cruzsbrian/smartwatch/watch_hw/watch.kicad_pcb

## KiCad design watch_hw/watch.kicad_pcb (2026-02-01)

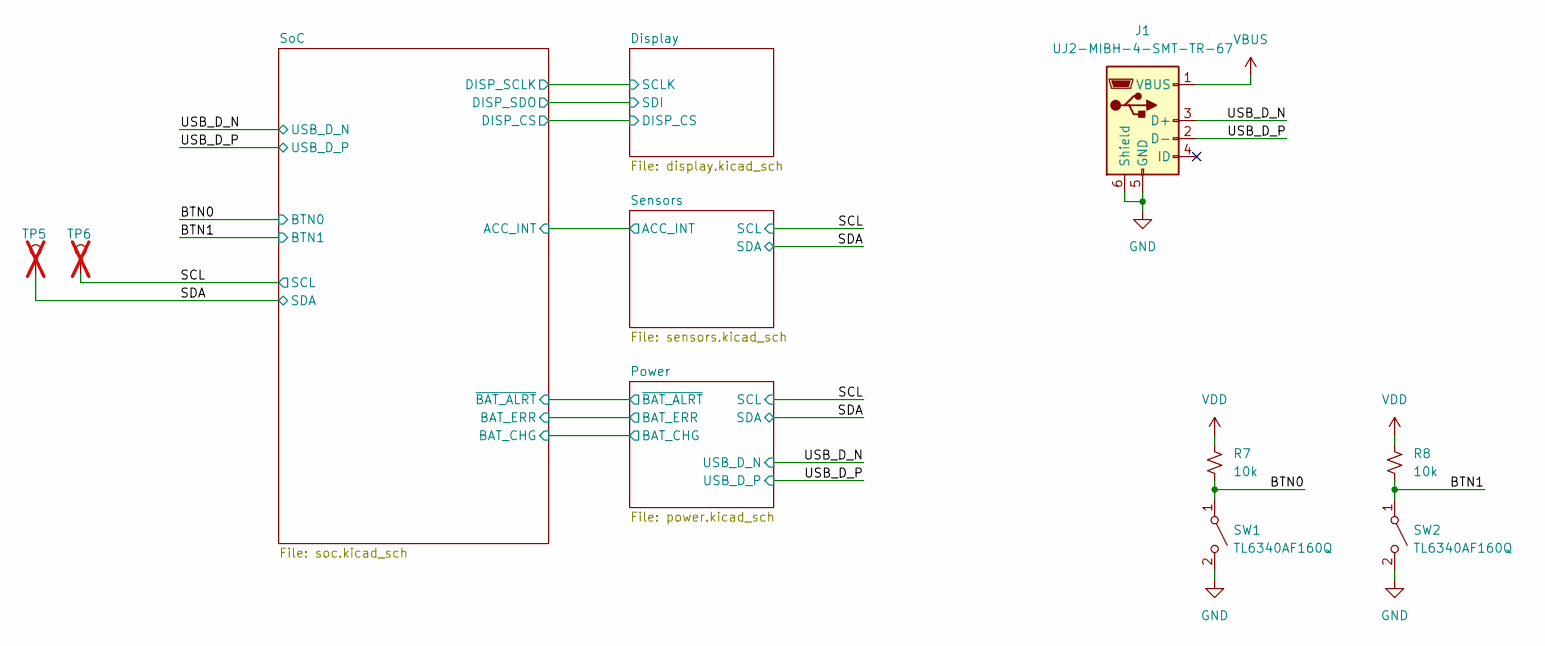
[picture p1: schematic watch.kicad_sch]

Parts:
J1: UJ2-MIBH-4-SMT-TR-67; Manufacturer Part Number UJ2-MIBH-4-SMT-TR-67; LCSC C22359766
R7, R8: 10k; R_0402_1005Metric_Pad0.72x0.64mm_HandSolder; Manufacturer Part Number 0402WGF1002TCE; LCSC C25744
SW1, SW2: TL6340AF160Q; SW_TL6340AF160Q; Manufacturer Part Number TL6340AF160Q; LCSC C4944967
TP5, TP6: TestPoint; TestPoint_Keystone_5015_Micro_Mini; not fitted

Connections:
/BTN0: R7.2, SW1.1 (A); also elsewhere on the board
/BTN1: R8.2, SW2.1 (A); also elsewhere on the board
/SCL: TP6.1; also elsewhere on the board
/SDA: TP5.1; also elsewhere on the board
/USB_D_N: J1.3 (D+); also elsewhere on the board
/USB_D_P: J1.2 (D-); also elsewhere on the board
GND: J1.5 (GND), J1.6 (Shield), SW1.2 (B), SW2.2 (B); also elsewhere on the board
VBUS: J1.1 (VBUS); also elsewhere on the board
VDD: R7.1, R8.1; also elsewhere on the board

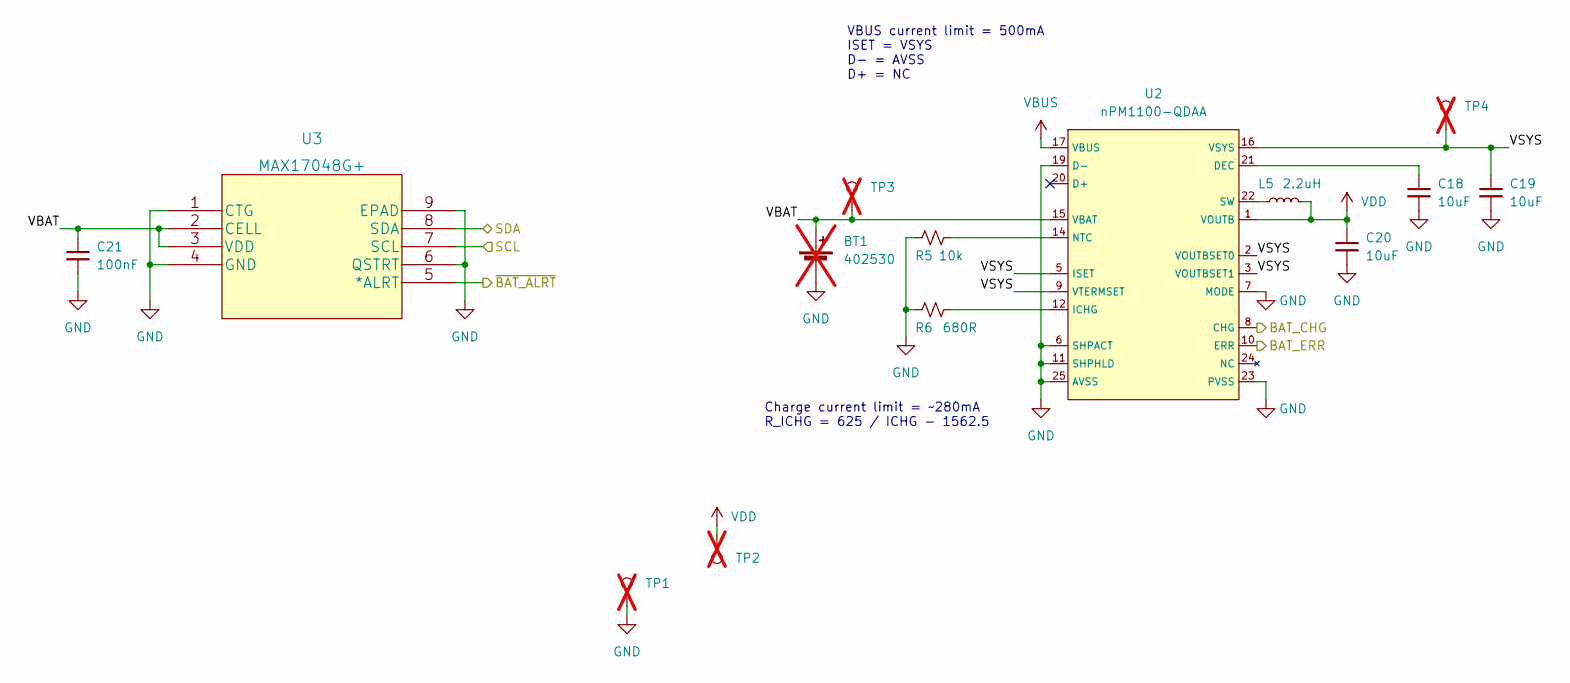
[picture p2: schematic power.kicad_sch]

Parts:
BT1: 402530; PinHeader_1x02_P1.27mm_Vertical; not fitted
C18, C19, C20: 10uF; C_0805_2012Metric_Pad1.18x1.45mm_HandSolder; Manufacturer Part Number CL21A106KAYNNNE; LCSC C15850
C21: 100nF; C_0402_1005Metric_Pad0.74x0.62mm_HandSolder; Manufacturer Part Number CL05B104KO5NNNC; LCSC C1525
L5: 2.2uH; L_0805_2012Metric_Pad1.05x1.20mm_HandSolder; Manufacturer Part Number LQM21PN2R2MGHL; LCSC C341781
R5: 10k; R_0402_1005Metric_Pad0.72x0.64mm_HandSolder; Manufacturer Part Number 0402WGF1002TCE; LCSC C25744
R6: 680R; R_0402_1005Metric_Pad0.72x0.64mm_HandSolder; Manufacturer Part Number 0402WGF6800TCE; LCSC C25130
TP1, TP2, TP3, TP4: TestPoint; TestPoint_Keystone_5015_Micro_Mini; not fitted
U2: nPM1100-QDAA; QFN-24-1EP_4x4mm_P0.5mm_EP2.15x2.15mm; Manufacturer Part Number NPM1100-QDAA-R; LCSC C5816773
U3: MAX17048G+; MAX17048G&plus_; Manufacturer Part Number MAX17048G+T10; LCSC C2682616

Connections:
/Power/BAT_CHG: U2.8 (CHG); also elsewhere on the board
/Power/BAT_ERR: U2.10 (ERR); also elsewhere on the board
/Power/VBAT: BT1.1 (+), C21.1, TP3.1, U2.15 (VBAT), U3.2 (CELL), U3.3 (VDD)
/Power/VSYS: C19.1, TP4.1, U2.2 (VOUTBSET0), U2.3 (VOUTBSET1), U2.5 (ISET), U2.9 (VTERMSET), U2.16 (VSYS)
/Power/~BAT_ALRT: U3.5 (*ALRT); also elsewhere on the board
/SCL: U3.7 (SCL); also elsewhere on the board
/SDA: U3.8 (SDA); also elsewhere on the board
GND: BT1.2 (-), C18.2, C19.2, C20.2, C21.2, R5.1, R6.1, TP1.1, U2.6 (SHPACT), U2.7 (MODE), U2.11 (SHPHLD), U2.19 (D-), U2.23 (PVSS), U2.25 (AVSS), U3.1 (CTG), U3.4 (GND), U3.6 (QSTRT), U3.9 (EPAD); also elsewhere on the board
unnamed: C18.1, U2.21 (DEC)
unnamed: R6.2, U2.12 (ICHG)
unnamed: R5.2, U2.14 (NTC)
unnamed: L5.1, U2.22 (SW)
VBUS: U2.17 (VBUS); also elsewhere on the board
VDD: C20.1, L5.2, TP2.1, U2.1 (VOUTB); also elsewhere on the board

Notes on the sheet:
Charge current limit = ~280mA R_ICHG = 625 / ICHG - 1562.5
VBUS current limit = 500mA ISET = VSYS D- = AVSS D+ = NC

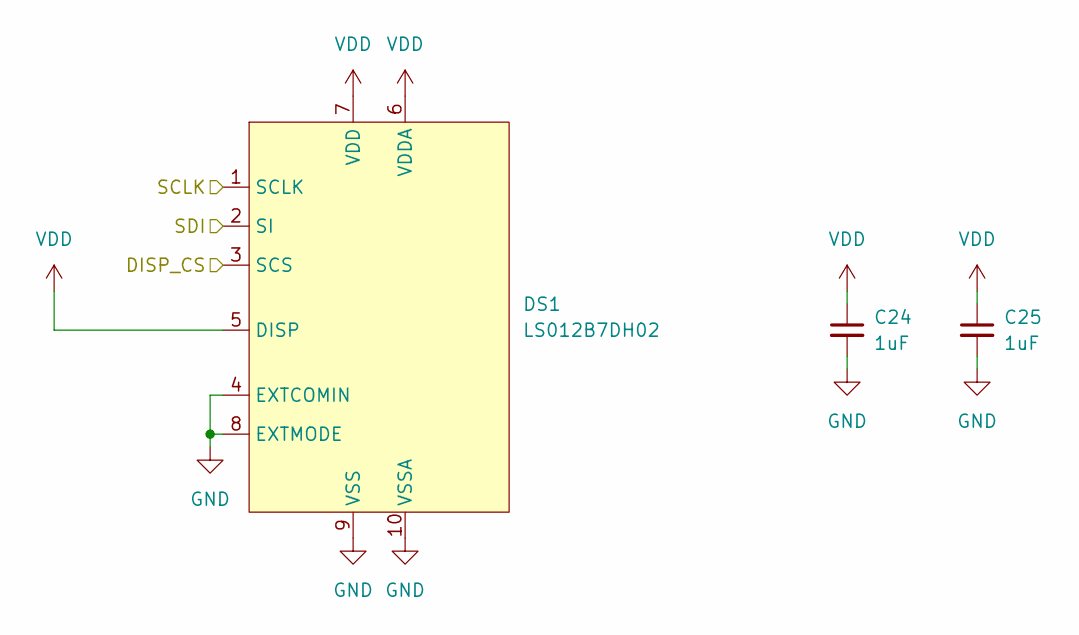
[picture p3: schematic display.kicad_sch]

Parts:
C24, C25: 1uF; C_0402_1005Metric_Pad0.74x0.62mm_HandSolder; Manufacturer Part Number CL05A105KA5NQNC; LCSC C52923
DS1: LS012B7DH02; AYF531035A; Manufacturer Part Number AYF531035A

Connections:
/Display/DISP_CS: DS1.3 (SCS); also elsewhere on the board
/Display/SCLK: DS1.1 (SCLK); also elsewhere on the board
/Display/SDI: DS1.2 (SI); also elsewhere on the board
GND: C24.2, C25.2, DS1.4 (EXTCOMIN), DS1.8 (EXTMODE), DS1.9 (VSS), DS1.10 (VSSA); also elsewhere on the board
VDD: C24.1, C25.1, DS1.5 (DISP), DS1.6 (VDDA), DS1.7 (VDD); also elsewhere on the board

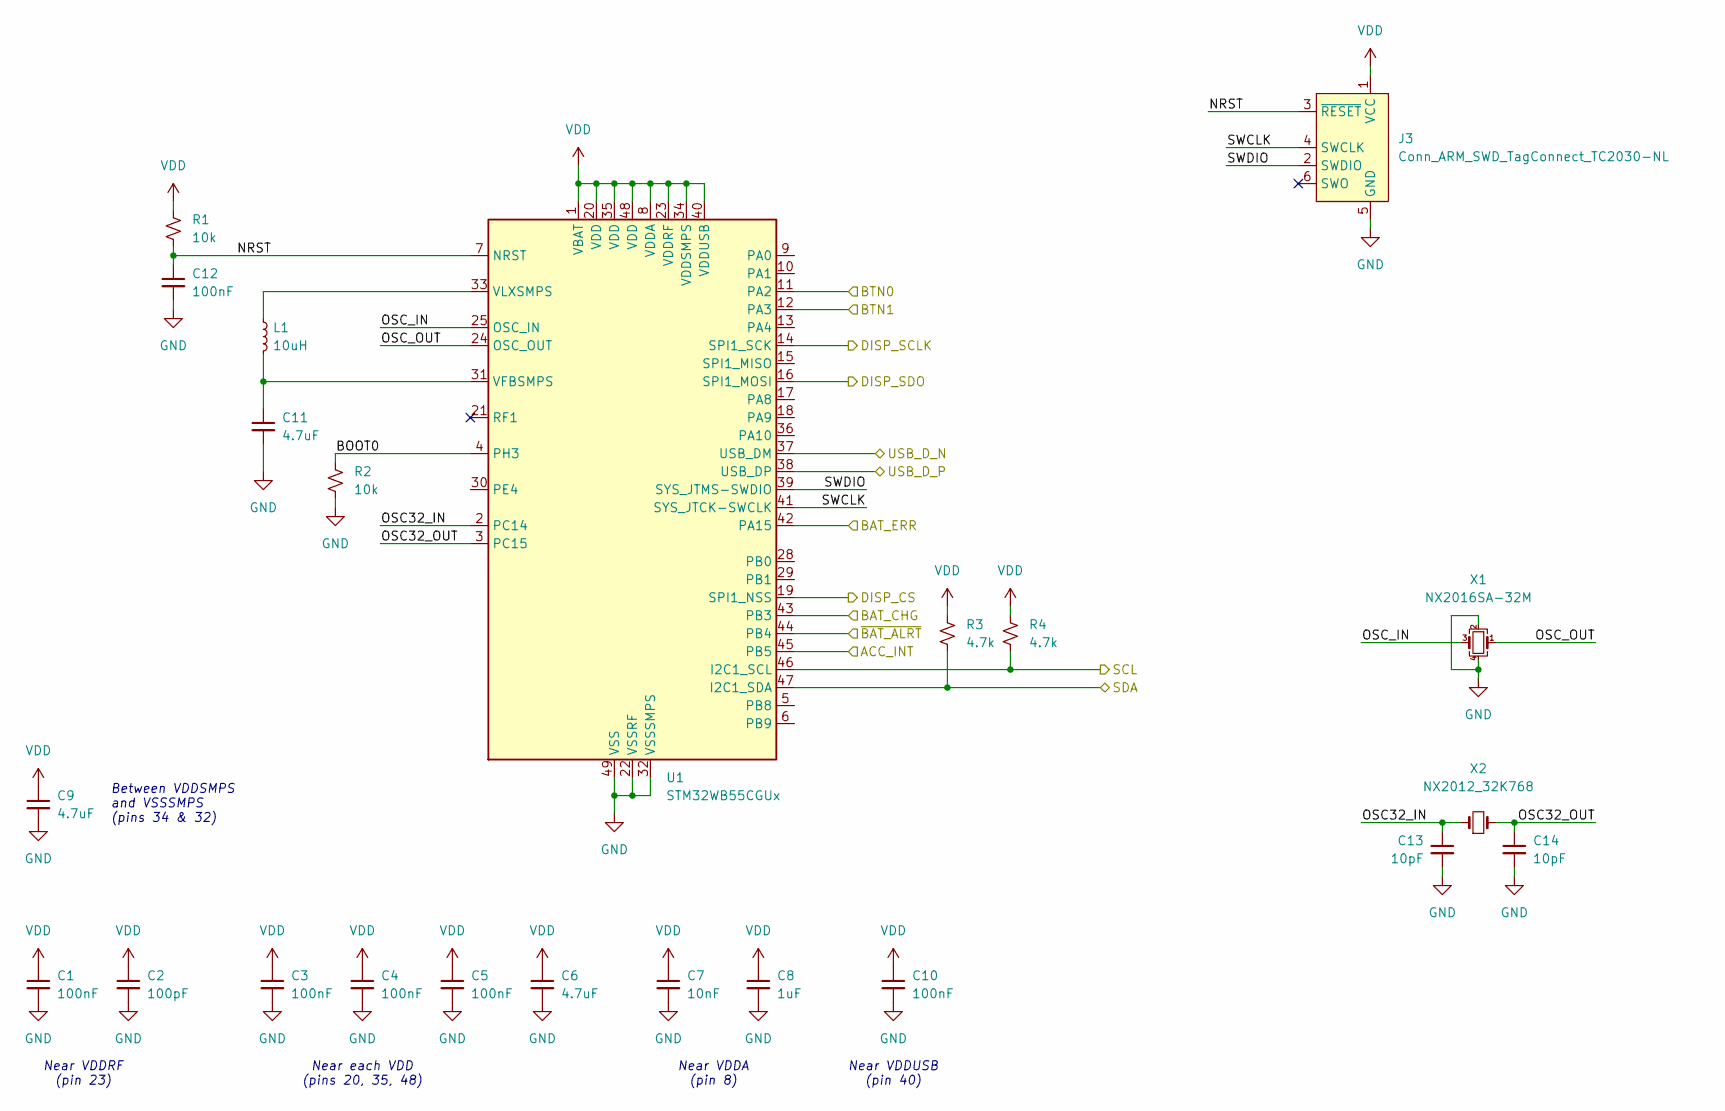
[picture p4: schematic soc.kicad_sch]

Parts:
C1, C3, C4, C5, C10, C12: 100nF; C_0402_1005Metric_Pad0.74x0.62mm_HandSolder; Manufacturer Part Number CL05B104KO5NNNC; LCSC C1525
C2: 100pF; C_0402_1005Metric_Pad0.74x0.62mm_HandSolder; Manufacturer Part Number CL05C101JB5NNNC; LCSC C26409
C6: 4.7uF; C_0402_1005Metric_Pad0.74x0.62mm_HandSolder; Manufacturer Part Number CL05A475MP5NRNC; LCSC C23733
C7: 10nF; C_0402_1005Metric_Pad0.74x0.62mm_HandSolder; Manufacturer Part Number CL05B103KB5NNNC; LCSC C15195
C8: 1uF; C_0402_1005Metric_Pad0.74x0.62mm_HandSolder; Manufacturer Part Number CL05A105KA5NQNC; LCSC C52923
C9, C11: 4.7uF; C_0603_1608Metric_Pad1.08x0.95mm_HandSolder; Manufacturer Part Number CL10A475KO8NNNC; LCSC C19666
C13, C14: 10pF; C_0402_1005Metric_Pad0.74x0.62mm_HandSolder; Manufacturer Part Number CL05C100JB5NNNC; LCSC C32949
J3: Conn_ARM_SWD_TagConnect_TC2030-NL; Tag-Connect_TC2030-IDC-NL_2x03_P1.27mm_Vertical
L1: 10uH; L_0805_2012Metric_Pad1.05x1.20mm_HandSolder; Manufacturer Part Number LQM21FN100M80L; LCSC C162582
R1, R2: 10k; R_0402_1005Metric_Pad0.72x0.64mm_HandSolder; Manufacturer Part Number 0402WGF1002TCE; LCSC C25744
R3, R4: 4.7k; R_0402_1005Metric_Pad0.72x0.64mm_HandSolder; Manufacturer Part Number 0402WGF4701TCE; LCSC C25900
U1: STM32WB55CGUx; QFN-48-1EP_7x7mm_P0.5mm_EP3.5x3.5mm; Manufacturer Part Number STM32WB55CGU6; LCSC C404023
X1: NX2016SA-32M; Crystal_SMD_2016-4Pin_2.0x1.6mm; Manufacturer Part Number NX2016SA-32MHZ-STD-CZS-5; LCSC C843260
X2: NX2012_32K768; Crystal_SMD_2012-2Pin_2.0x1.2mm_HandSoldering; Manufacturer Part Number NX2012SA-32.768KHZ-STD-MUB-2; LCSC C891748

Connections:
/BTN0: U1.11 (PA2); also elsewhere on the board
/BTN1: U1.12 (PA3); also elsewhere on the board
/Display/DISP_CS: U1.19 (SPI1_NSS); also elsewhere on the board
/Display/SCLK: U1.14 (SPI1_SCK); also elsewhere on the board
/Display/SDI: U1.16 (SPI1_MOSI); also elsewhere on the board
/Power/BAT_CHG: U1.43 (PB3); also elsewhere on the board
/Power/BAT_ERR: U1.42 (PA15); also elsewhere on the board
/Power/~BAT_ALRT: U1.44 (PB4); also elsewhere on the board
/SCL: R4.2, U1.46 (I2C1_SCL); also elsewhere on the board
/SDA: R3.2, U1.47 (I2C1_SDA); also elsewhere on the board
/Sensors/ACC_INT: U1.45 (PB5); also elsewhere on the board
/SoC/BOOT0: R2.1, U1.4 (PH3)
/SoC/NRST: C12.1, J3.3 (~RESET), R1.2, U1.7 (NRST)
/SoC/OSC32_IN: C13.1, U1.2 (PC14), X2.1
/SoC/OSC32_OUT: C14.1, U1.3 (PC15), X2.2
/SoC/OSC_IN: U1.25 (OSC_IN), X1.3
/SoC/OSC_OUT: U1.24 (OSC_OUT), X1.1
/SoC/SWCLK: J3.4 (SWCLK), U1.41 (SYS_JTCK-SWCLK)
/SoC/SWDIO: J3.2 (SWDIO), U1.39 (SYS_JTMS-SWDIO)
/USB_D_N: U1.37 (USB_DM); also elsewhere on the board
/USB_D_P: U1.38 (USB_DP); also elsewhere on the board
GND: C1.2, C2.2, C3.2, C4.2, C5.2, C6.2, C7.2, C8.2, C9.2, C10.2, C11.2, C12.2, C13.2, C14.2, J3.5 (GND), R2.2, U1.22 (VSSRF), U1.32 (VSSSMPS), U1.49 (VSS), X1.2, X1.4; also elsewhere on the board
unnamed: C11.1, L1.2, U1.31 (VFBSMPS)
unnamed: L1.1, U1.33 (VLXSMPS)
VDD: C1.1, C2.1, C3.1, C4.1, C5.1, C6.1, C7.1, C8.1, C9.1, C10.1, J3.1 (VCC), R1.1, R3.1, R4.1, U1.1 (VBAT), U1.8 (VDDA), U1.20 (VDD), U1.23 (VDDRF), U1.34 (VDDSMPS), U1.35 (VDD), U1.40 (VDDUSB), U1.48 (VDD); also elsewhere on the board

Notes on the sheet:
Near VDDUSB (pin 40)
Between VDDSMPS and VSSSMPS (pins 34 & 32)
Near VDDA (pin 8)
Near each VDD (pins 20, 35, 48)
Near VDDRF (pin 23)

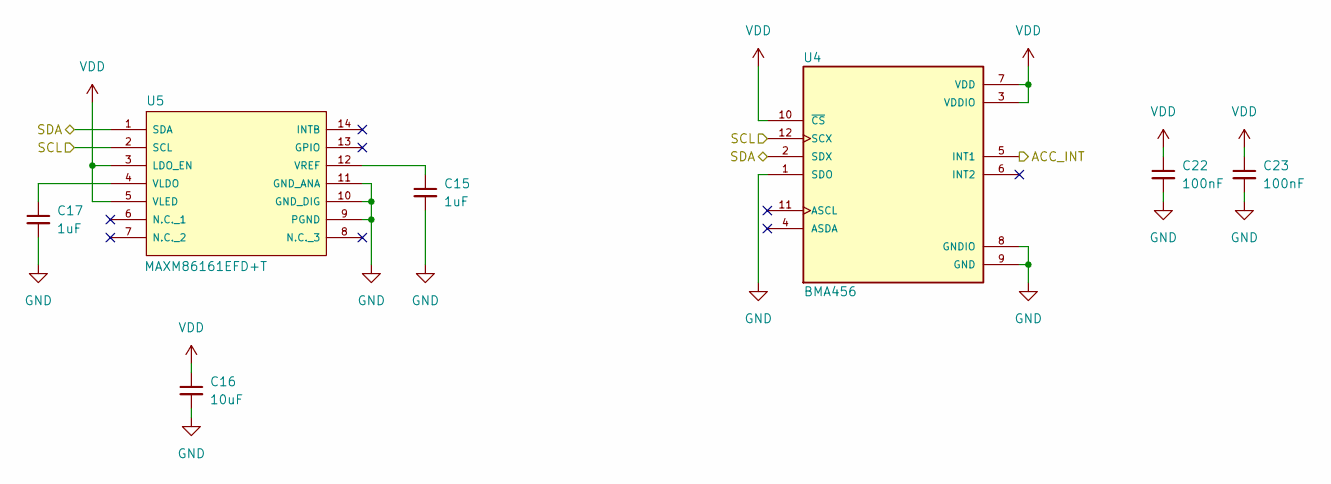
[picture p5: schematic sensors.kicad_sch]

Parts:
C15, C17: 1uF; C_0402_1005Metric_Pad0.74x0.62mm_HandSolder; Manufacturer Part Number CL05A105KA5NQNC; LCSC C52923
C16: 10uF; C_0805_2012Metric_Pad1.18x1.45mm_HandSolder; Manufacturer Part Number CL21A106KAYNNNE; LCSC C15850
C22, C23: 100nF; C_0402_1005Metric_Pad0.74x0.62mm_HandSolder; Manufacturer Part Number CL05B104KO5NNNC; LCSC C1525
U4: BMA456; XDCR_BMA456; PARTREV 2.0; LCSC C189518
U5: MAXM86161EFD+T; MAXM86161EFDT; Manufacturer Part Number MAXM86161EFD+T; LCSC C3178309

Connections:
/SCL: U4.12 (SCX), U5.2 (SCL); also elsewhere on the board
/SDA: U4.2 (SDX), U5.1 (SDA); also elsewhere on the board
/Sensors/ACC_INT: U4.5 (INT1); also elsewhere on the board
GND: C15.2, C16.2, C17.2, C22.2, C23.2, U4.1 (SDO), U4.8 (GNDIO), U4.9 (GND), U5.9 (PGND), U5.10 (GND_DIG), U5.11 (GND_ANA); also elsewhere on the board
unnamed: C17.1, U5.4 (VLDO)
unnamed: C15.1, U5.12 (VREF)
VDD: C16.1, C22.1, C23.1, U4.3 (VDDIO), U4.7 (VDD), U4.10 (~CS), U5.3 (LDO_EN), U5.5 (VLED); also elsewhere on the board

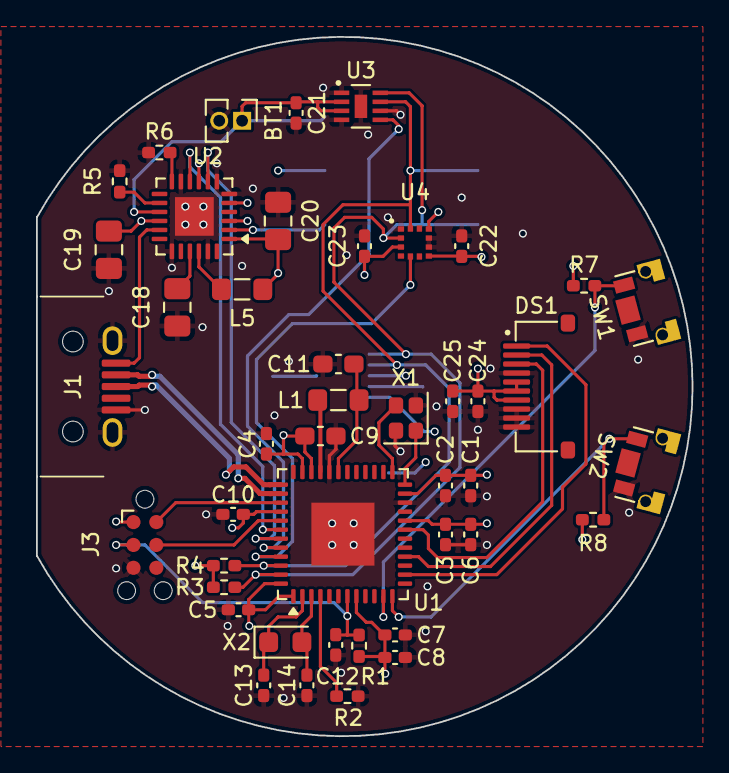
[picture p6: board watch.kicad_pcb from above]

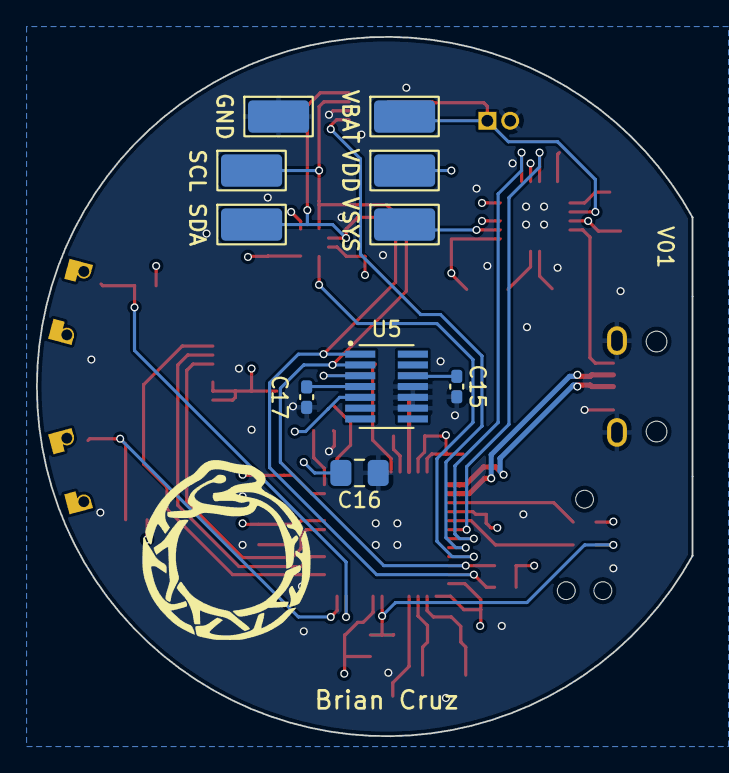
[picture p7: board watch.kicad_pcb from below]

Board: 6 copper layers, 36.4 x 38.8 mm, 55 parts (10 on the bottom side), 34 nets.

Other parts of the board:
DISP: LS012B7DH02
