cruzsbrian/smartwatch/breakout_boards/hr_brkt/hr_brkt.kicad_pcb

## KiCad design breakout_boards/hr_brkt/hr_brkt.kicad_pcb (2024-07-24)

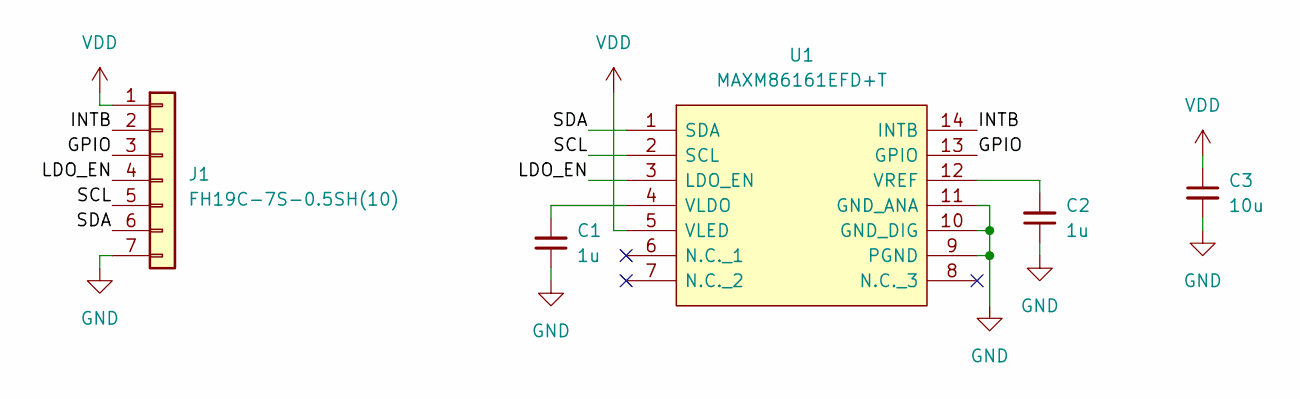
[picture p8: schematic hr_brkt.kicad_sch]

Parts:
C1, C2: 1u; C_0402_1005Metric_Pad0.74x0.62mm_HandSolder
C3: 10u; C_0402_1005Metric_Pad0.74x0.62mm_HandSolder
J1: FH19C-7S-0.5SH(10); FH19C_FPC
U1: MAXM86161EFD+T; MAXM86161EFDT; Mouser Part Number 700-MAXM86161EFD+T

Connections:
/GPIO: J1.3, U1.13 (GPIO)
/INTB: J1.2, U1.14 (INTB)
/LDO_EN: J1.4, U1.3 (LDO_EN)
/SCL: J1.5, U1.2 (SCL)
/SDA: J1.6, U1.1 (SDA)
GND: C1.1, C2.1, C3.2, J1.7, U1.9 (PGND), U1.10 (GND_DIG), U1.11 (GND_ANA)
unnamed: C1.2, U1.4 (VLDO)
unnamed: C2.2, U1.12 (VREF)
VDD: C3.1, J1.1, U1.5 (VLED)

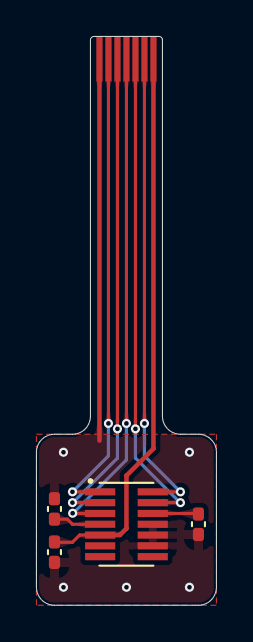
[picture p9: board hr_brkt.kicad_pcb from above]

Board: 2 copper layers, 10.0 x 31.6 mm, 5 parts (0 on the bottom side), 9 nets.
