cruzsbrian/smartwatch/breakout_boards/acc_brkt/acc_brkt.kicad_pcb

## KiCad design breakout_boards/acc_brkt/acc_brkt.kicad_pcb (2024-07-24)

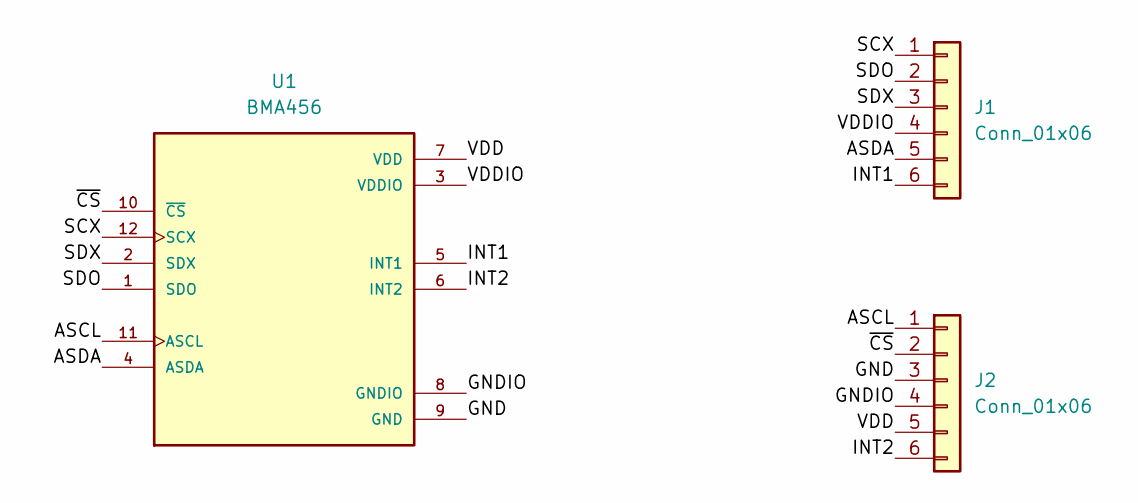
[picture p10: schematic acc_brkt.kicad_sch]

Parts:
J1, J2: Conn_01x06; PinHeader_1x06_P2.54mm_Vertical
U1: BMA456; XDCR_BMA456; PARTREV 2.0

Connections:
/ASCL: J2.1, U1.11 (ASCL)
/ASDA: J1.5, U1.4 (ASDA)
/GND: J2.3, U1.9 (GND)
/GNDIO: J2.4, U1.8 (GNDIO)
/INT1: J1.6, U1.5 (INT1)
/INT2: J2.6, U1.6 (INT2)
/SCX: J1.1, U1.12 (SCX)
/SDO: J1.2, U1.1 (SDO)
/SDX: J1.3, U1.2 (SDX)
/VDD: J2.5, U1.7 (VDD)
/VDDIO: J1.4, U1.3 (VDDIO)
/~CS: J2.2, U1.10 (~CS)

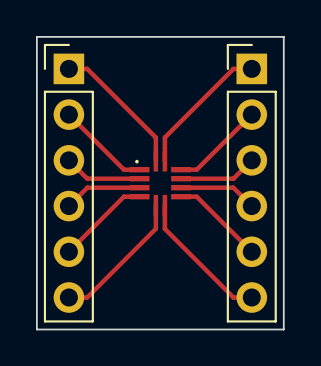
[picture p11: board acc_brkt.kicad_pcb from above]

Board: 2 copper layers, 13.7 x 16.3 mm, 3 parts (0 on the bottom side), 12 nets.
