cruzsbrian/smartwatch/breakout_boards/reflective_lcd_brkt/reflective_lcd_brkt.kicad_pcb

## KiCad design breakout_boards/reflective_lcd_brkt/reflective_lcd_brkt.kicad_pcb (2024-07-24)

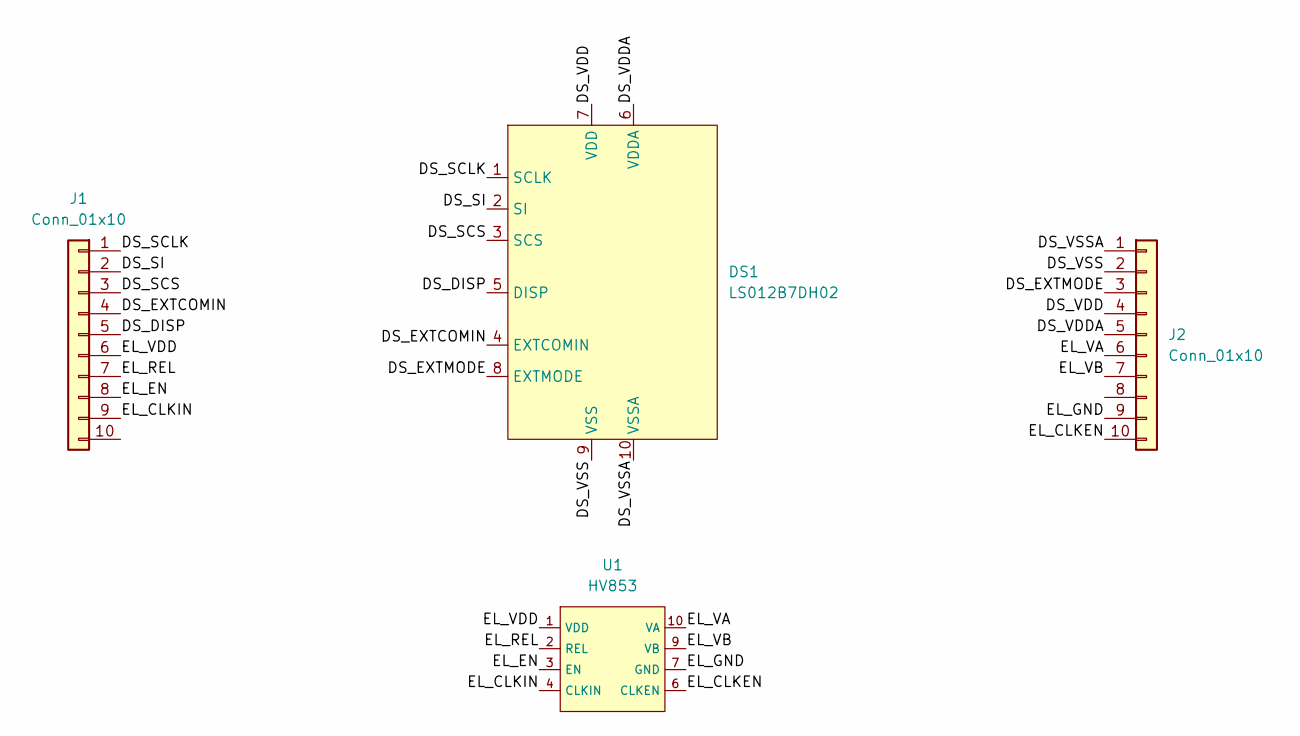
[picture p12: schematic reflective_lcd_brkt.kicad_sch]

Parts:
DS1: LS012B7DH02; AYF531035A
J1: Conn_01x10
J2: Conn_01x10; PinHeader_1x10_P2.54mm_Vertical
U1: HV853; DFN-10-1EP_3x3mm_P0.5mm_EP1.65x2.38mm

Connections:
/DS_DISP: DS1.5 (DISP), J1.5
/DS_EXTCOMIN: DS1.4 (EXTCOMIN), J1.4
/DS_EXTMODE: DS1.8 (EXTMODE), J2.3
/DS_SCLK: DS1.1 (SCLK), J1.1
/DS_SCS: DS1.3 (SCS), J1.3
/DS_SI: DS1.2 (SI), J1.2
/DS_VDD: DS1.7 (VDD), J2.4
/DS_VDDA: DS1.6 (VDDA), J2.5
/DS_VSS: DS1.9 (VSS), J2.2
/DS_VSSA: DS1.10 (VSSA), J2.1
/EL_CLKEN: J2.10, U1.6 (CLKEN)
/EL_CLKIN: J1.9, U1.4 (CLKIN)
/EL_EN: J1.8, U1.3 (EN)
/EL_REL: J1.7, U1.2 (REL)
/EL_VA: J2.6, U1.10 (VA)
/EL_VB: J2.7, U1.9 (VB)
/EL_VDD: J1.6, U1.1 (VDD)
GND: J2.8, J2.9, U1.7 (GND), U1.8 (GND)

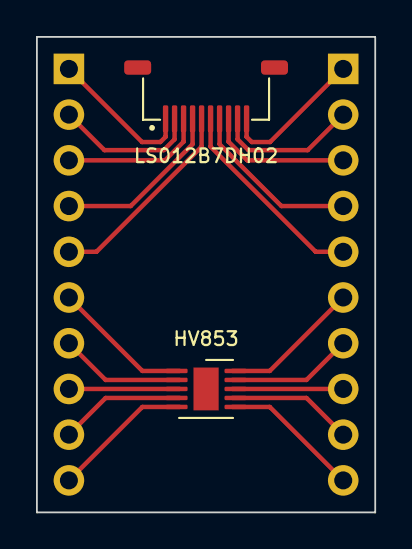
[picture p13: board reflective_lcd_brkt.kicad_pcb from above]

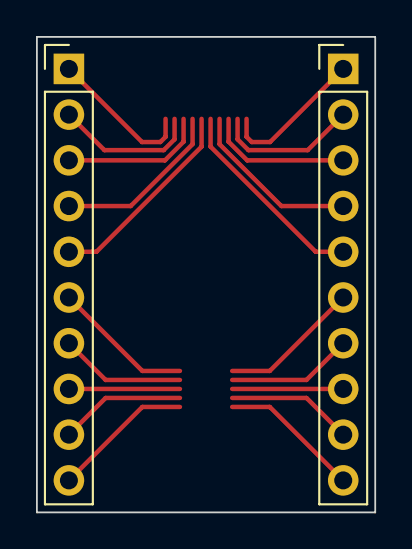
[picture p14: board reflective_lcd_brkt.kicad_pcb from below]

Board: 2 copper layers, 18.8 x 26.4 mm, 4 parts (2 on the bottom side), 18 nets.
