cruzsbrian/smartwatch/breakout_boards/battery_brkt/battery_brkt.kicad_pcb

## KiCad design breakout_boards/battery_brkt/battery_brkt.kicad_pcb (2024-07-24)

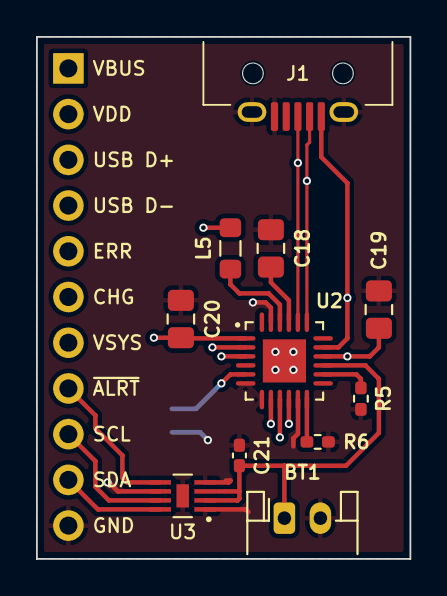
[picture p15: board battery_brkt.kicad_pcb from above]

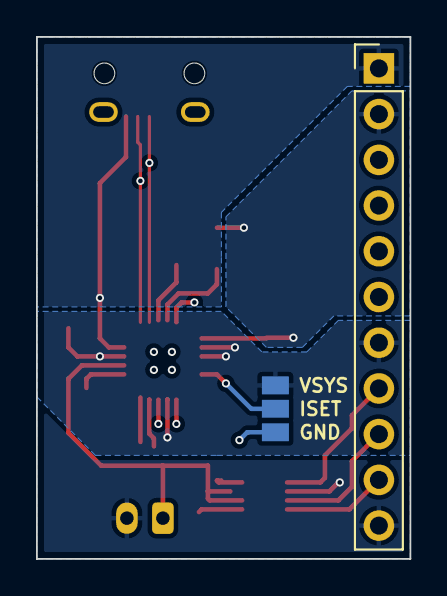
[picture p16: board battery_brkt.kicad_pcb from below]

Board: 4 copper layers, 20.8 x 29.0 mm, 13 parts (2 on the bottom side), 17 nets.

Parts:
BT1: 402530; JST_PH_S2B-PH-K_1x02_P2.00mm_Horizontal
C18, C19, C20: 10uF; C_0805_2012Metric_Pad1.18x1.45mm_HandSolder
C21: 0.1uF; C_0402_1005Metric_Pad0.74x0.62mm_HandSolder
J1: USB_B_Micro; UJ2-MIBH-4-SMT-TR-67
J2: Conn_01x11; PinHeader_1x11_P2.54mm_Vertical
JP1: SolderJumper_3_Open; SolderJumper-3_P1.3mm_Open_Pad1.0x1.5mm
L5: 2.2uH; L_0805_2012Metric_Pad1.05x1.20mm_HandSolder
R5: 10k; R_0402_1005Metric_Pad0.72x0.64mm_HandSolder
R6: 560R; R_0402_1005Metric_Pad0.72x0.64mm_HandSolder
U2: nPM1100-QD
U3: MAX17048G+; MAX17048G&plus_

Connections:
/BAT_CHG: J2.6, U2.8 (CHG)
/BAT_ERR: J2.5, U2.10 (ERR)
/ISET: JP1.2 (C), U2.5 (ISET)
/SCL: J2.9, U3.7 (SCL)
/SDA: J2.10, U3.8 (SDA)
/USB_D_N: J1.2 (D-), J2.4, U2.19 (D-)
/USB_D_P: J1.3 (D+), J2.3, U2.20 (D+)
/VBAT: BT1.1 (+), C21.1, U2.15 (VBAT), U3.2 (CELL), U3.3 (VDD)
/VSYS: C19.1, J2.7, JP1.1 (A), U2.2 (VOUTBSET0), U2.3 (VOUTBSET1), U2.9 (VTERMSET), U2.16 (VSYS)
/~BAT_ALRT: J2.8, U3.5 (*ALRT)
GND: BT1.2 (-), C18.2, C19.2, C20.2, C21.2, J1.5 (GND), J1.6 (Shield), J2.11, JP1.3 (B), R5.1, R6.1, U2.6 (SHPACT), U2.7 (MODE), U2.11 (SHPHLD), U2.23 (PVSS), U2.PAD, U3.1 (CTG), U3.4 (GND), U3.6 (QSTRT), U3.9 (EPAD)
unnamed: C18.1, U2.21 (DEC)
unnamed: R6.2, U2.12 (ICHG)
unnamed: R5.2, U2.14 (NTC)
unnamed: L5.1, U2.22 (SW)
VBUS: J1.1 (VBUS), J2.1, U2.17 (VBUS)
VDD: C20.1, J2.2, L5.2, U2.1 (VOUTB)
