cruzsbrian/smartwatch/(commit log)

2023-09-26 Finalize (?) part selection, start layout
    [bluenrg.kicad_sch, display.kicad_sch, nRF52.kicad_sch, power.kicad_sch, sensors.kicad_sch, soc.kicad_sch, watch.kicad_pcb, watch.kicad_sch]
2023-10-08 Routing progress
    [display.kicad_sch, sensors.kicad_sch, soc.kicad_sch, watch.kicad_pcb, watch.kicad_sch]
2024-07-22 Clean up library symbols, update to kicad 8
    [display.kicad_sch, power.kicad_sch, sensors.kicad_sch, soc.kicad_sch, watch.kicad_pcb, watch.kicad_sch]
2024-07-24 Add breakout boards, exclude gerbers from git
    [acc_brkt.kicad_pcb, acc_brkt.kicad_sch, battery_brkt.kicad_pcb, battery_brkt.kicad_sch, hr_brkt-rounded.kicad_pcb, hr_brkt.kicad_pcb, hr_brkt.kicad_sch, lcd_brkt.kicad_pcb]
2024-07-24 SCH: add STM32 and most passives
    [soc.kicad_sch]
2025-09-20 Start watch v1 layout
    [display.kicad_sch, power.kicad_sch, sensors.kicad_sch, soc.kicad_sch, watch.kicad_pcb, watch.kicad_sch]
2026-01-06 Add pulse sensor straight to board, fix NPM1100 symbol/footprint
    [power.kicad_sch, sensors.kicad_sch, watch.kicad_pcb]
2026-01-06 Route usb data
    [soc.kicad_sch, watch.kicad_pcb, watch.kicad_sch]
2026-01-11 route a bunch, update USB plug board edge
    [soc.kicad_sch, watch.kicad_pcb, watch.kicad_sch]
2026-01-11 route a bunch more
    [watch.kicad_pcb]
2026-01-12 finish routing, need to fix DRC
    [power.kicad_sch, soc.kicad_sch, watch.kicad_pcb]
2026-01-13 pass DRC
    [soc.kicad_sch, watch.kicad_pcb]
2026-01-13 fix 3D models
    [watch.kicad_pcb]
2026-01-13 move tagconnect slightly
    [watch.kicad_pcb]
2026-01-29 Add manufacturer/PN fields, select LCSC parts
    [display.kicad_sch, power.kicad_sch, sensors.kicad_sch, soc.kicad_sch, watch.kicad_sch]
2026-01-29 Slightly increase silkscreen text size
    [watch.kicad_pcb]
2026-01-29 Add ouroboros art
    [watch.kicad_pcb]
2026-01-29 Finish adding MPN info
    [display.kicad_sch, power.kicad_sch, sensors.kicad_sch, soc.kicad_sch, watch.kicad_sch]
2026-02-01 Expand via size for JLC
    [watch-B_Cu.gbl, watch-B_Mask.gbs, watch-B_Paste.gbp, watch-B_Silkscreen.gbo, watch-Edge_Cuts.gm1, watch-F_Cu.gtl, watch-F_Mask.gts, watch-F_Paste.gtp]
